Alejandro-Casanova/Proyecto-Arduino-Regulaci-n-Autom-tica/README.md

# Trabajo de Regulación Automática con Arduino

Trabajo opcional realizado para la asignatura de Regulación Automática del Grado de Ingeniería Electrónica Industrial y Automática. Consiste en dos ventiladores enfrentados. El primer ventilador se mantiene estable en 1500 rpm ante las perturbaciones introducidas por el segundo ventilador.
